makehumantechnology/co2ampel/docs/README.md

# Assembly instructions

Case: top parts

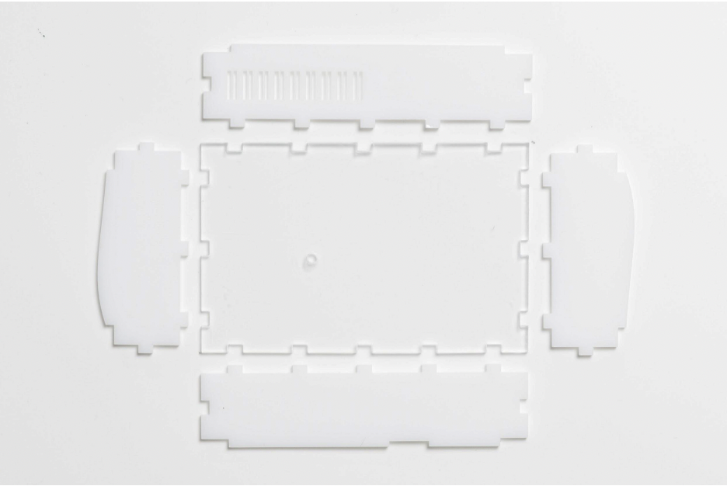
[picture p2: docs/step1.png]


Case: top parts assembled

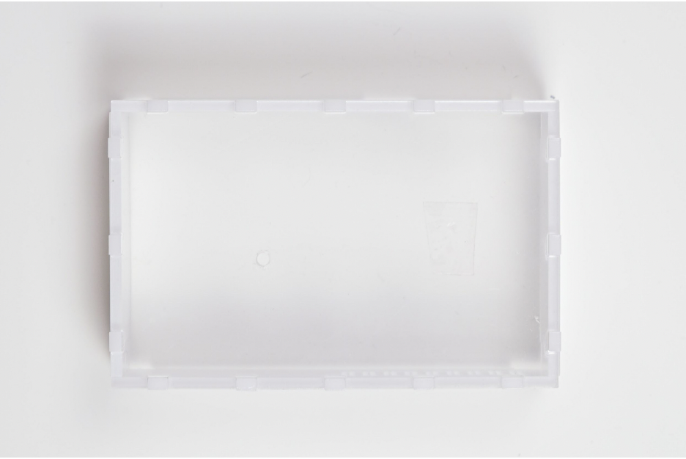
[picture p3: docs/step2.png]


Case: bottom part

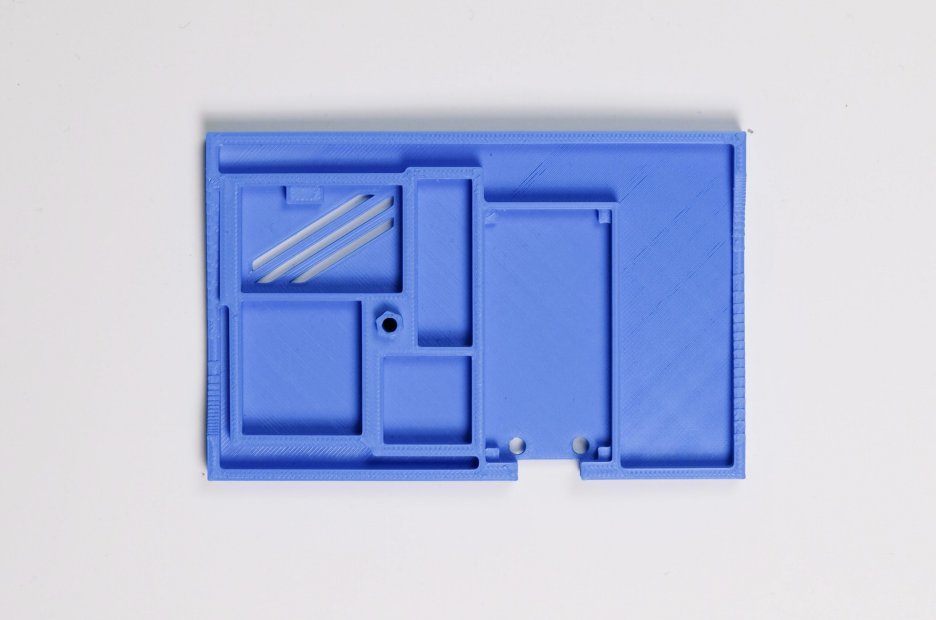
[picture p4: docs/step3.png]


Connector cables

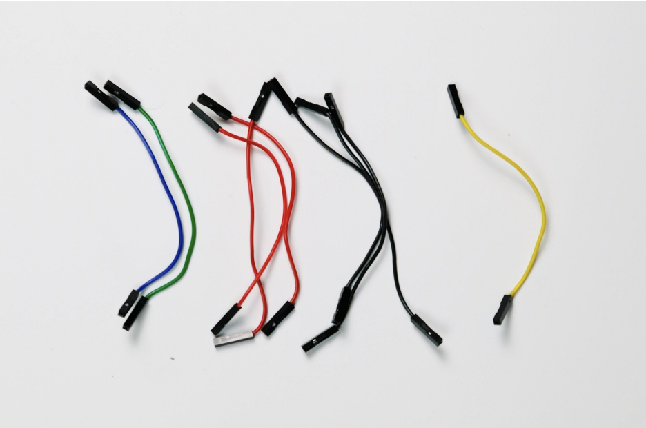
[picture p5: docs/step4.png]


1 yellow cable
3 red cables
3 black cables
1 green cable
1 blue cable

Bridge Board

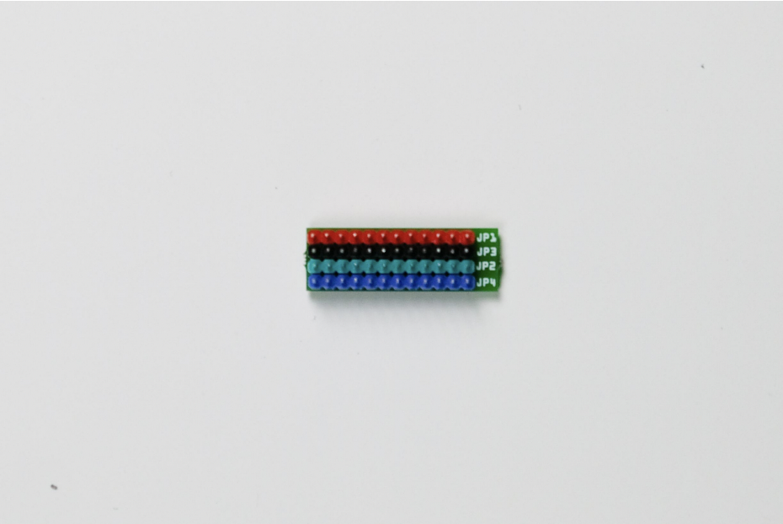
[picture p6: docs/step5.png]


Install cables on bridge board

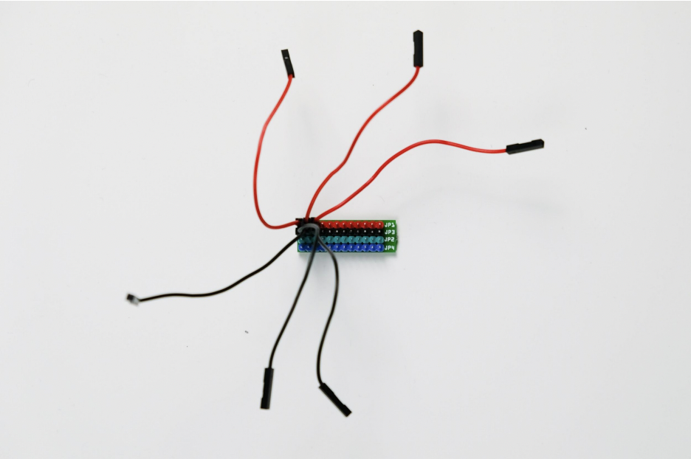
[picture p7: docs/step6.png]


Place components on case bottom part

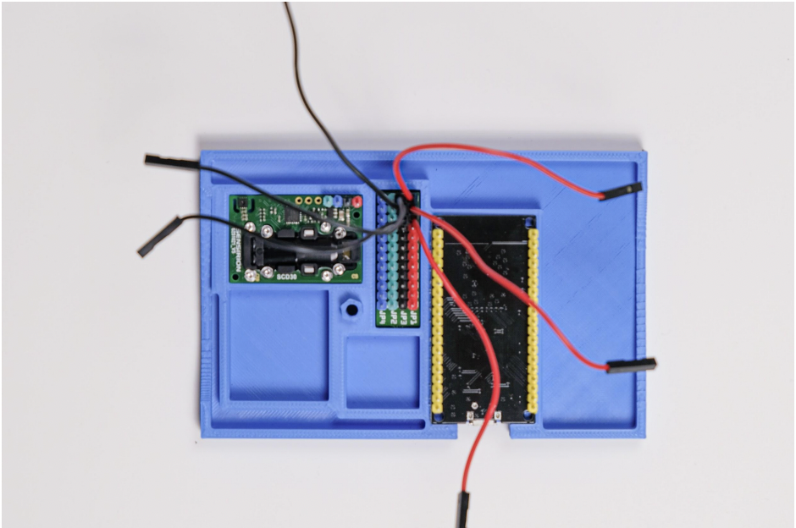
[picture p8: docs/step7.png]


Install fixation plate

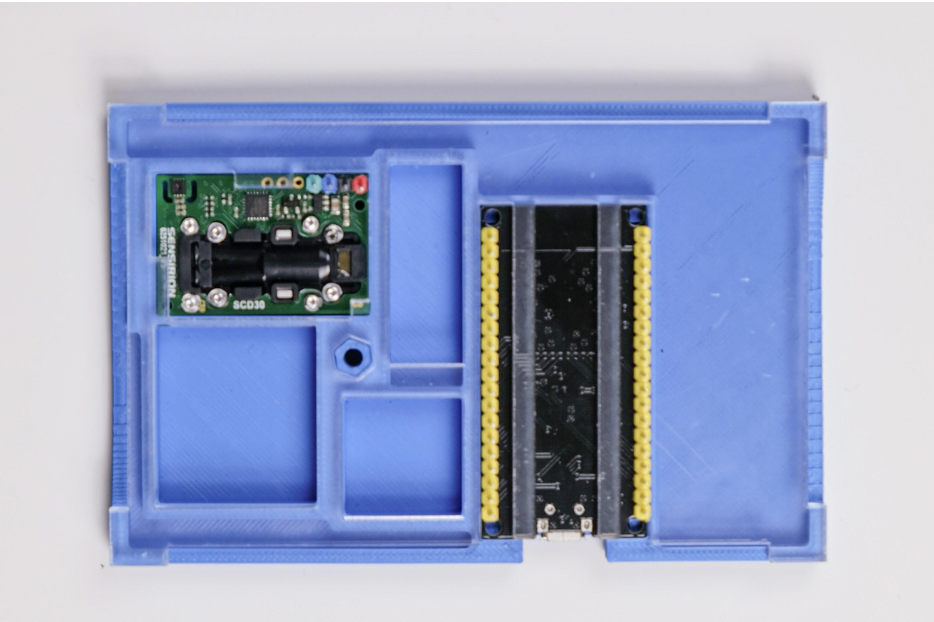
[picture p9: docs/step8.png]


CPU-Board Pin Reference

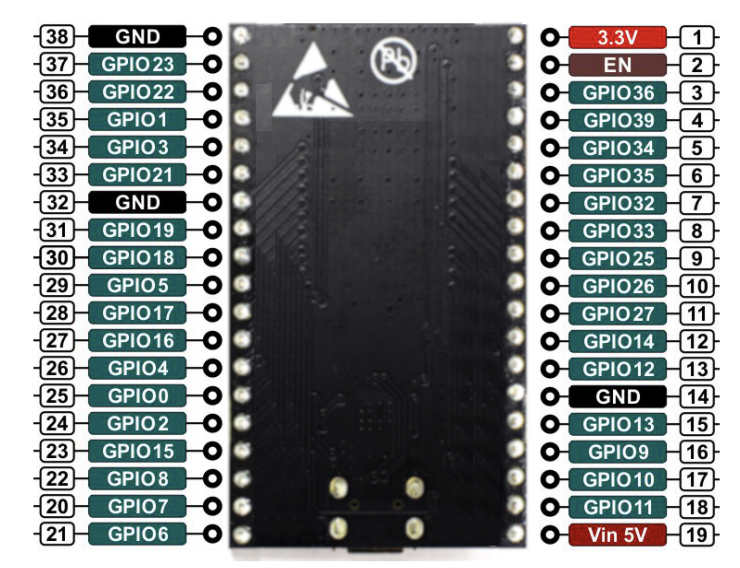
[picture p10: docs/step9.png]


Connect red cables

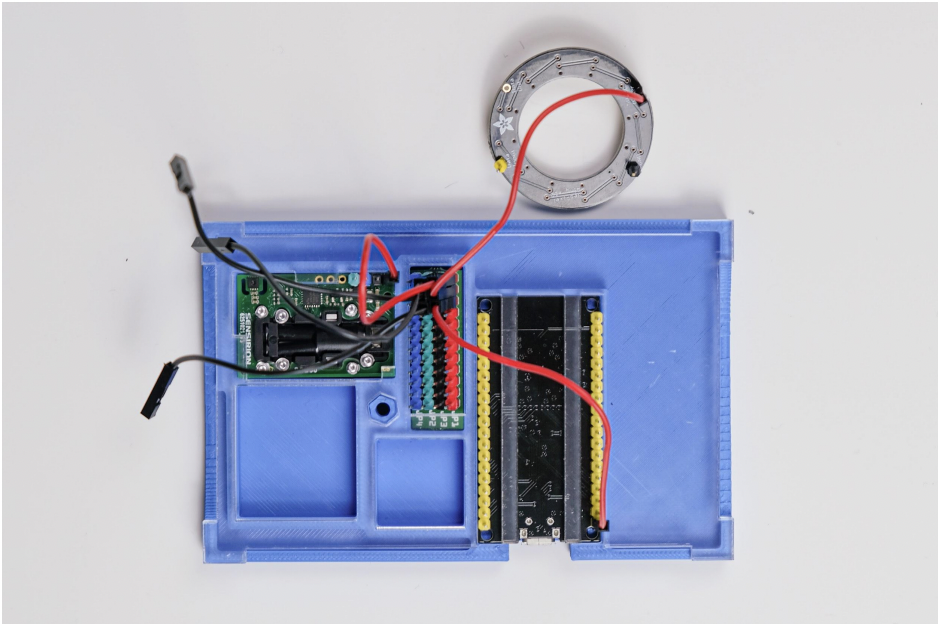
[picture p11: docs/step10.png]


Connect black cables

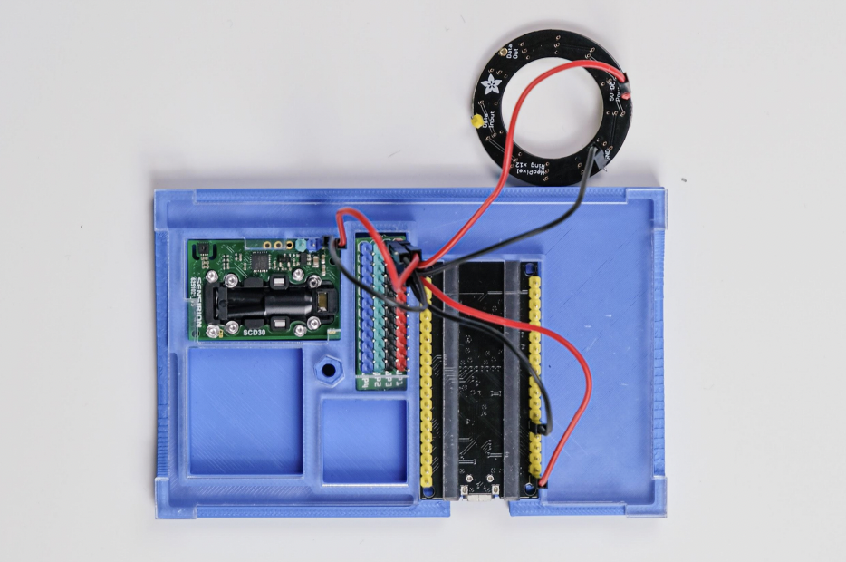
[picture p12: docs/step11.png]


Connect yellow cable

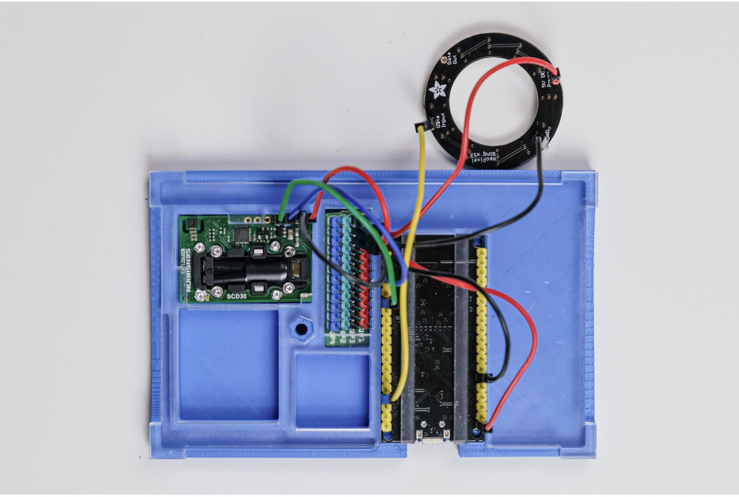
[picture p13: docs/step12.png]


Connect blue cable

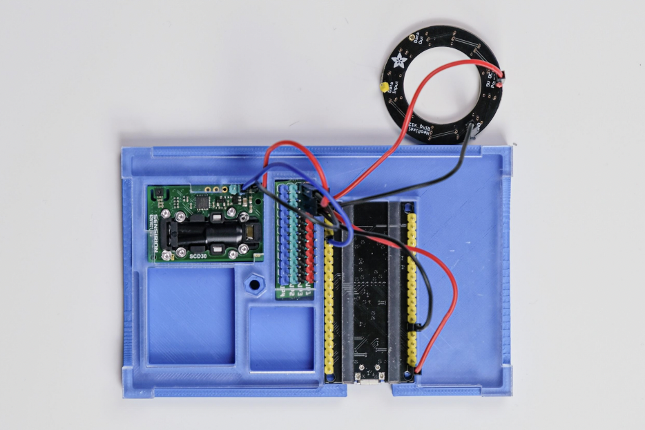
[picture p14: docs/step13.png]


Connect green cable

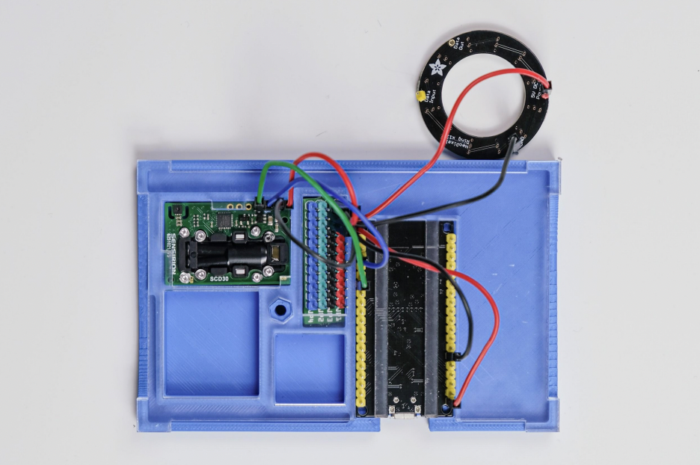
[picture p15: docs/step14.png]


Double-sided tape

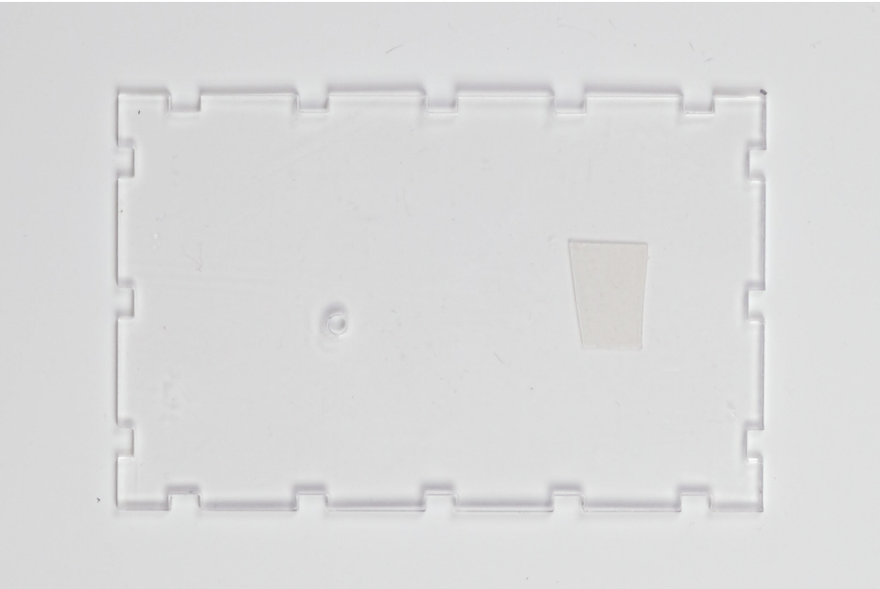
[picture p16: docs/step15.png]


Attach LED Ring to case top

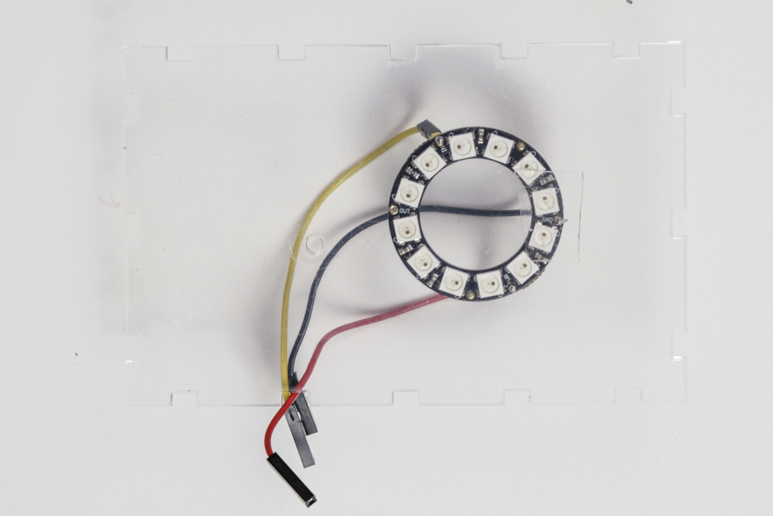
[picture p17: docs/step16.png]


Finish by closing case with screw and nut

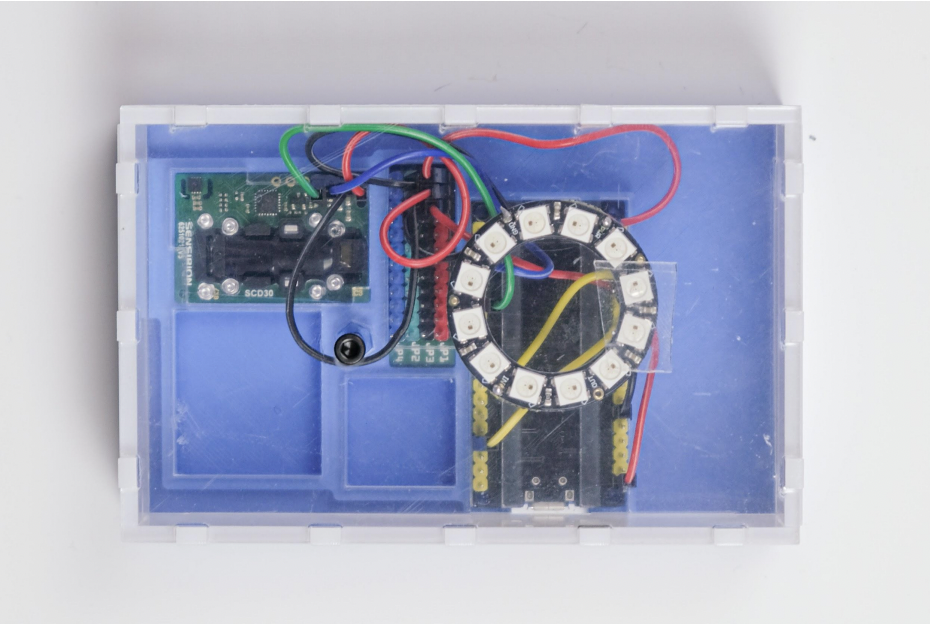
[picture p18: docs/step17.png]
