makehumantechnology/co2ampel/svg/README.md

Use 3mm Acrylic Glass (PMMA). We use clear one for the top parts and white for the sideparts.
