makehumantechnology/co2ampel/stl/README.md

Print this with PLA or PET/G in a color of your choice. Does not need supports. Infill: 15%
