makehumantechnology/co2ampel/board/README.md

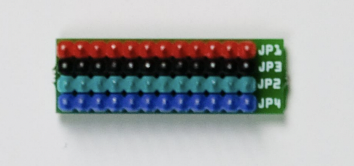
[picture p19: board/powerboard.png]
