makehumantechnology/co2ampel/stl/unterseite_neu_v6.stl

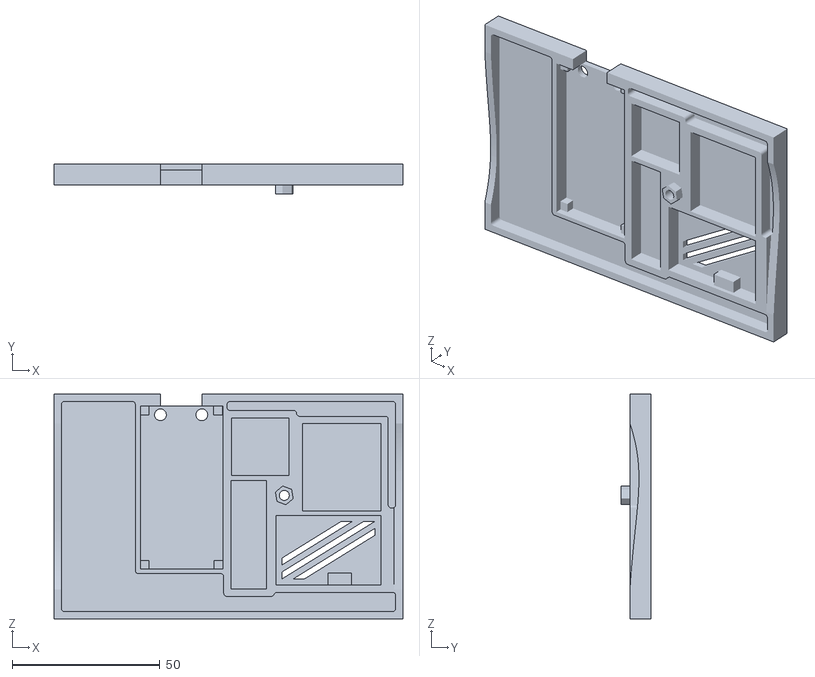
[picture p20: CAD file, 2022-07-30]
stl/unterseite_neu_v6.stl
118.0 x 10.1 x 76.0
