makehumantechnology/co2ampel/(list of files, drawings)

Other design files:
board/powerboard_ampel.fzz
